corywalker/vhdl_fft/README.md

vhdl_fft
========

An FPGA implementation of the Cooley-Tukey FFT algorithm in VHDL
