corywalker/vhdl_fft/docs/spi_notes.txt

screen /dev/tty.usbserial-A800crT2 115200

Be sure to set the second voltage option when connecting using the Bus Pirate.
