corywalker/vhdl_fft/docs/final_report/vhdl_fft.pdf

12/2/2014 | vhdl_fft.svg

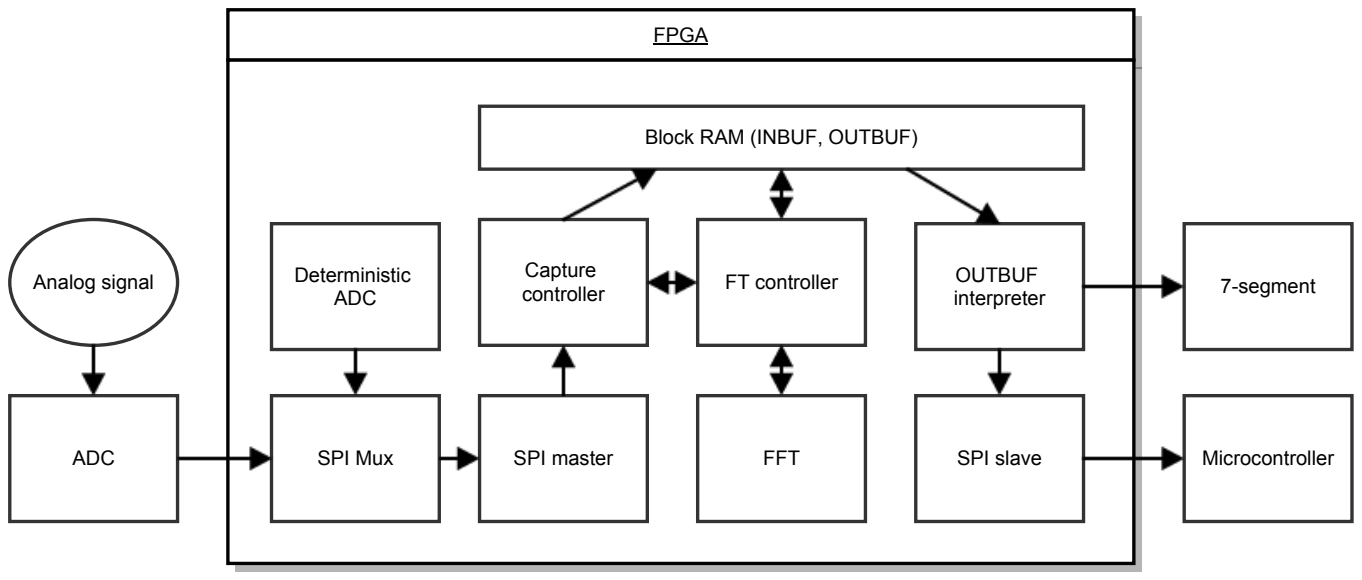
[picture p5: figure]
FPGA; ADC; Deterministic ADC; Analog signal; SPI Mux; Block RAM (INBUF, OUTBUF); Capture controller; FT controller; SPI master; FFT; SPI slave; OUTBUF interpreter; Microcontroller; 7-segment

file:///Users/cwalker32/Downloads/vhdl_fft.svg | 1/1
