corywalker/vhdl_fft/arduino/Screen Shot 2014-11-04 at 8.24.14 PM.png

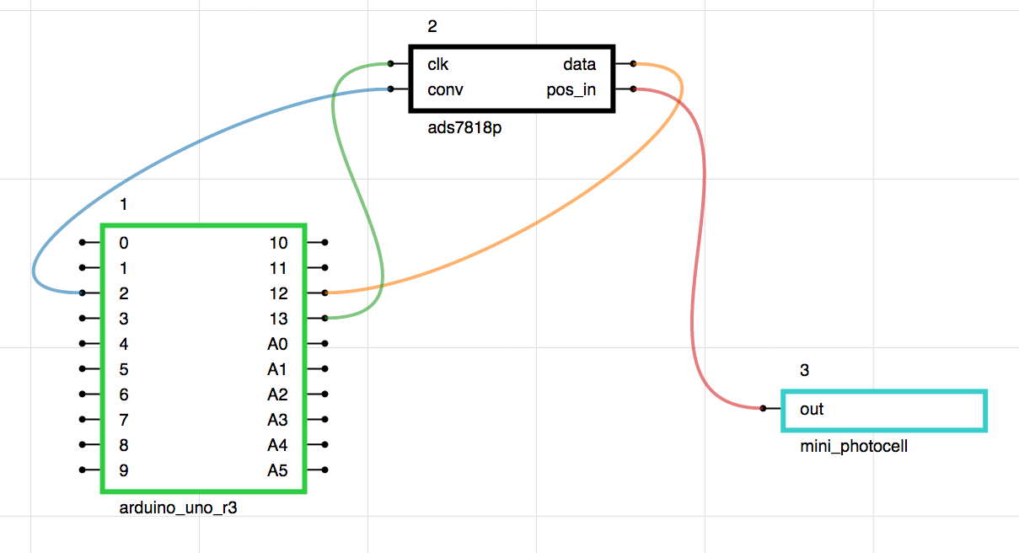
arduino/Screen Shot 2014-11-04 at 8.24.14 PM.png
