corywalker/vhdl_fft/arduino/Screen Shot 2014-11-05 at 11.52.24 PM.png

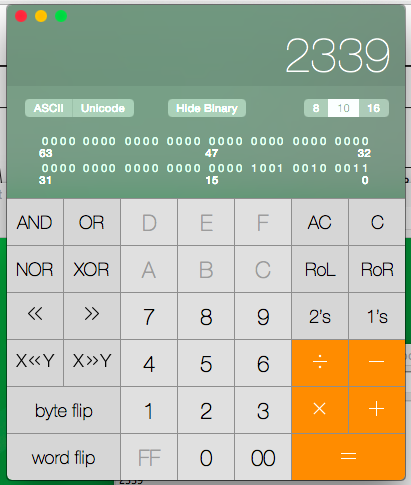
arduino/Screen Shot 2014-11-05 at 11.52.24 PM.png
