corywalker/vhdl_fft/arduino/Screen Shot 2014-11-05 at 11.58.07 PM.png

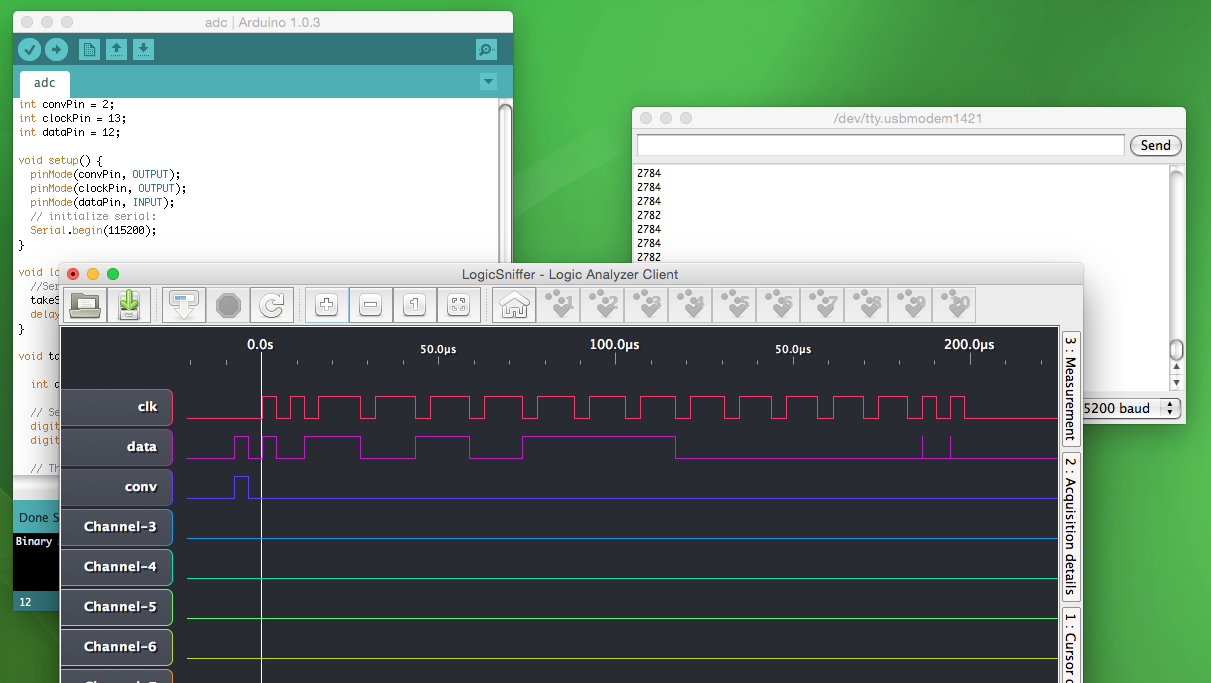
arduino/Screen Shot 2014-11-05 at 11.58.07 PM.png
