corywalker/vhdl_fft/docs/final_report/IMG_2986.JPG

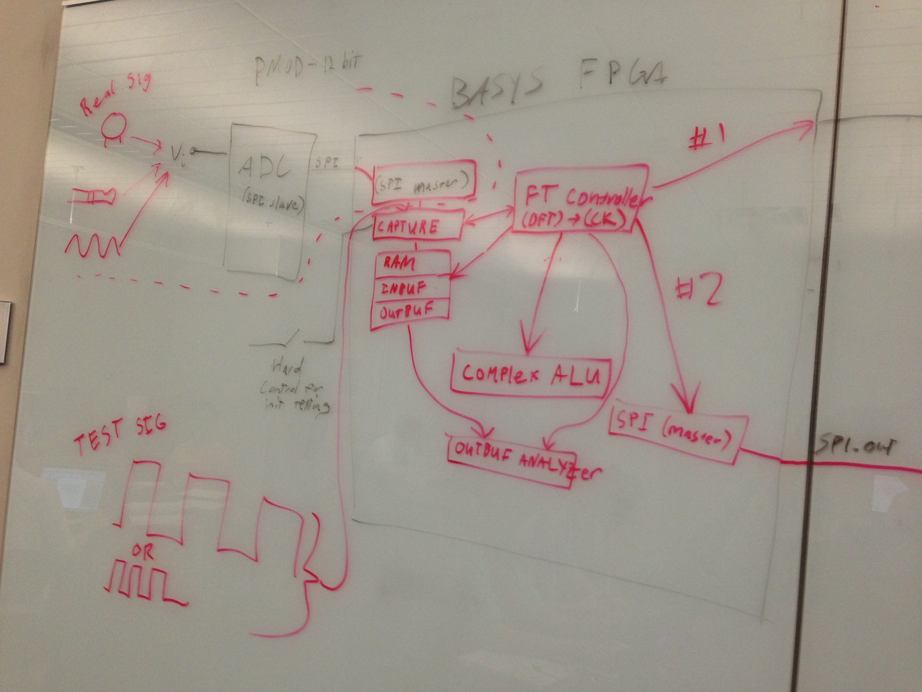
docs/final_report/IMG_2986.JPG
