corywalker/vhdl_fft/docs/final_report/IMG_2987.JPG

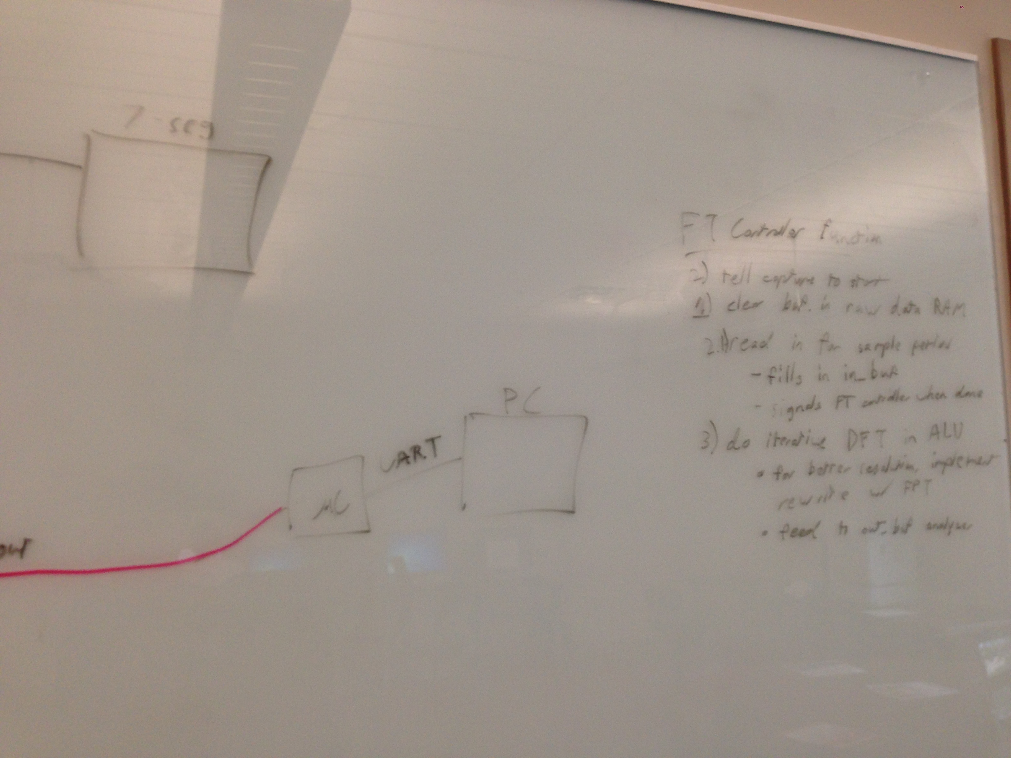
docs/final_report/IMG_2987.JPG
