corywalker/vhdl_fft/docs/IMG_3045.JPG

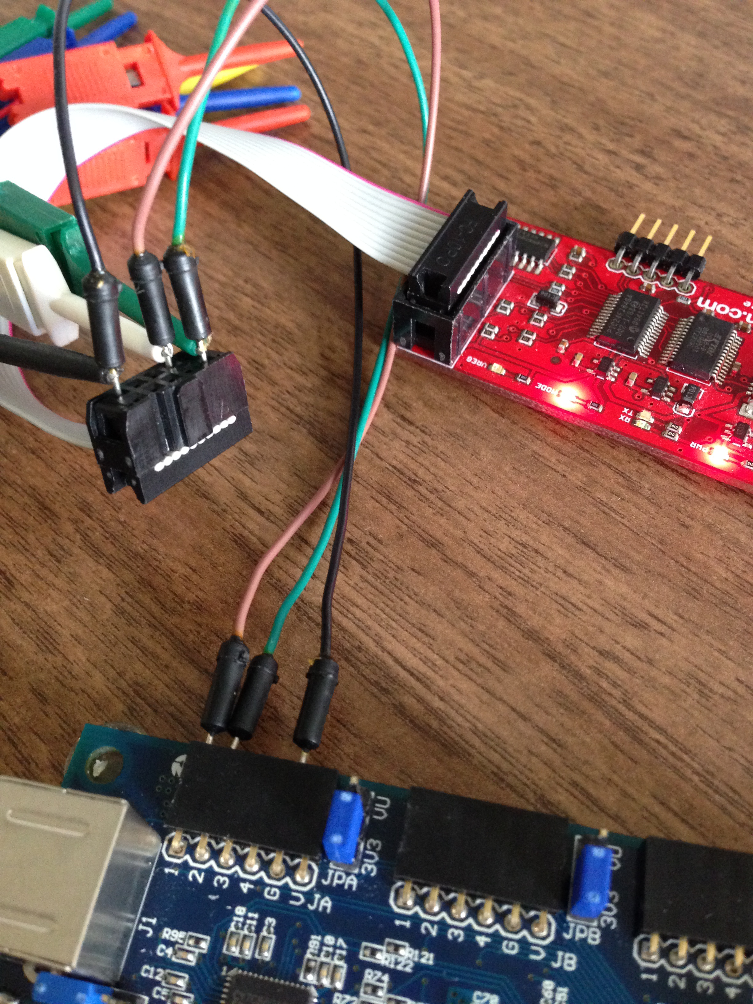
docs/IMG_3045.JPG
