corywalker/vhdl_fft/docs/planning/sims/cap_controller.PNG

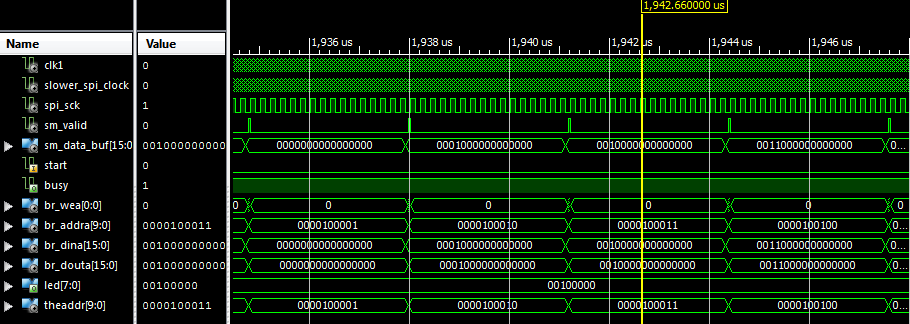
docs/planning/sims/cap_controller.PNG
