corywalker/vhdl_fft/docs/planning/sims/spi_master.PNG

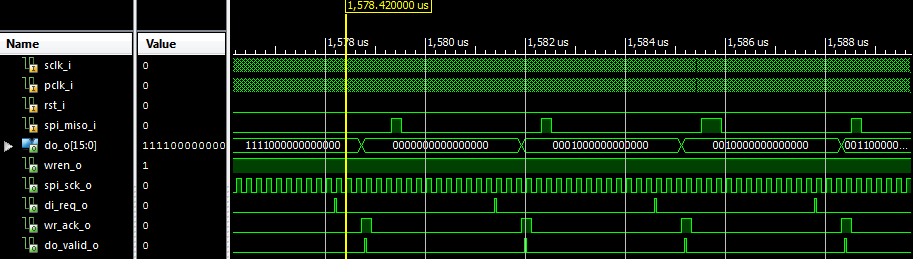
docs/planning/sims/spi_master.PNG
