corywalker/vhdl_fft/docs/Screen Shot 2014-09-27 at 6.52.34 PM.png

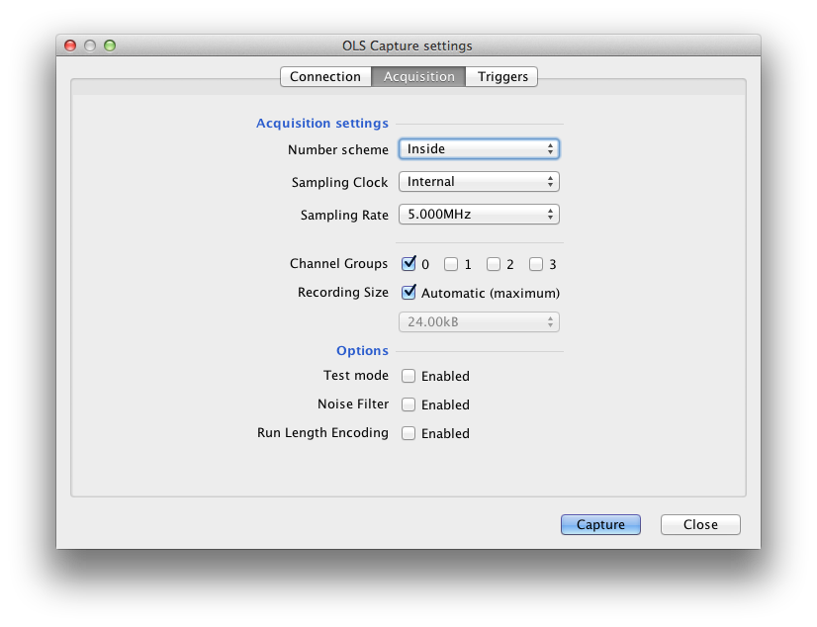
docs/Screen Shot 2014-09-27 at 6.52.34 PM.png
