corywalker/vhdl_fft/docs/Screen Shot 2014-09-27 at 6.52.38 PM.png

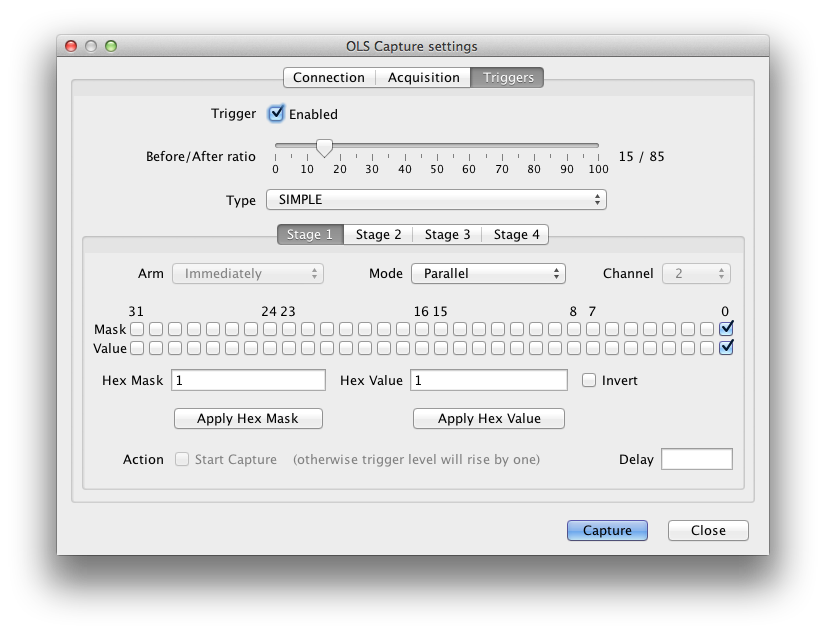
docs/Screen Shot 2014-09-27 at 6.52.38 PM.png
