corywalker/vhdl_fft/(commit log)

2014-09-13 Initial example commit. Added extensive .gitignore that filters out ISE intermediates.
2014-09-13 Add spi-master-slave OpenCore
2014-09-17 SPI works now.
2014-09-17 determ_adc now has a counter. This will be used to reset the signal after a certain time delay.
    [counter.vhd, counter_tb.vhd, determ_adc.vhd]
2014-09-18 Fixed a few small signal bugs. Still has a bug where if the state is > 0x10, MISO remains high.
    [counter.vhd, determ_adc.vhd]
2014-09-27 Synthesizes, but the output was changed. Probably doesn't work.
    [determ_adc.vhd]
2014-09-27 Fixed a longstanding bug where the first word was invalid.
    [determ_adc.vhd, determ_adc_tb.vhd]
2014-09-27 SPI now fully works - no visible bugs.
    [determ_adc.vhd]
2014-09-27 Added SPI documentation.
2014-10-20 Started work on the capture controller. Doesn't quite work yet.
    [cap_controller.vhd, cap_controller_tb.vhd]
2014-10-21 Internal SPI master module works, need to implement rest of cap_controller and spi_mux
2014-10-21 Implemented SPI mux
2014-10-22 cap_controller mostly written, just doesn't write samples to memory yet.
    [cap_controller.vhd, cap_controller_tb.vhd, determ_adc.vhd]
2014-11-06 Arduino control of ADC chip.
2014-11-10 Now samples at ~40kHz with a 100MHz clock speed. Still need some restructuring of determ_adc and then I can switch to the actual one.
2014-11-10 Format of determ_adc now mimics the TI ADC. Time to use it for real.
2014-11-10 Now works with real ADC
2014-11-10 Added Mathematica code and some Arduino sketches.
2014-11-12 Reading seems to work in simulation with some bugs.
    [ft_controller.vhd, ft_controller_tb.vhd, outbuf_interp.vhd]
2014-11-12 No bugs in simulation
    [ft_controller_tb.vhd, outbuf_interp.vhd]
2014-11-12 SPI output now works in real testing.
2014-11-12 Arduino sketch for oscilloscope.
2014-11-14 Added Arduino debug mode.
2014-11-14 Random changes that do not work.
    [osc_binary.ino, osc_client.pde, osc_client_2.pde]
2014-11-14 Framerate of 5.4 fps with python script.
2014-11-14 Framerate is now 22.
2014-11-14 Bug fixes on the VHDL side of the project.
    [cap_controller.vhd, ft_controller.vhd, ft_controller_tb.vhd]
2014-11-21 Prepping for reversed bit order.
    [cap_controller.vhd, ft_controller.vhd, ft_controller_tb.vhd]
2014-11-23 Fixed some logic in the ft_controller state machine. Needs a larger sample size to see if its really working. Example waveform updated too.
    [ft_controller.vhd]
2014-12-02 Added note about ADC interface.
